Kamalbura/esp32-rc-race-car/calibration/logs/transmitter_aggressive_20260416_031819.csv

step_index | step_name | host_time_ms | device_ms | seq | A0 | A1 | A2 | A3 | enc_bits | enc_delta | sent | errors | ack
1 | center_rest | 24286 | 1888 | 1 | 18304 | 17711 | 18286 | 17692 | 3 | -1 | 1 | 0 | 0
1 | center_rest | 24286 | 1922 | 1 | 18306 | 17718 | 18291 | 17697 | 3 | -1 | 1 | 0 | 1
1 | center_rest | 24287 | 1937 | 1 | 18307 | 17715 | 18286 | 17692 | 3 | -1 | 1 | 0 | 1
1 | center_rest | 24287 | 1952 | 2 | 17900 | 17385 | 18284 | 17689 | 3 | -1 | 2 | 0 | 2
1 | center_rest | 24287 | 1966 | 2 | 18319 | 17717 | 18289 | 17692 | 3 | -1 | 2 | 0 | 2
1 | center_rest | 24288 | 1980 | 2 | 18307 | 17712 | 18282 | 17689 | 3 | -1 | 2 | 0 | 2
1 | center_rest | 24288 | 1995 | 3 | 18307 | 17705 | 18282 | 17684 | 3 | -1 | 3 | 0 | 2
1 | center_rest | 24289 | 2010 | 3 | 18304 | 17707 | 18284 | 17690 | 3 | -1 | 3 | 0 | 3
1 | center_rest | 24289 | 2024 | 3 | 18306 | 17717 | 18288 | 17692 | 3 | -1 | 3 | 0 | 3
1 | center_rest | 24289 | 2038 | 3 | 18307 | 17714 | 18286 | 17687 | 3 | -1 | 3 | 0 | 3
1 | center_rest | 24290 | 2072 | 4 | 18306 | 17708 | 18283 | 17698 | 3 | -1 | 4 | 0 | 3
1 | center_rest | 24290 | 2087 | 4 | 18302 | 17712 | 18282 | 17689 | 3 | -1 | 4 | 0 | 4
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
