Kamalbura/esp32-rc-race-car/receiver_code/secrets.example.h

#pragma once

// ESP-NOW pairing configuration.
//
// This file is gitignored. Copy secrets.h.example to secrets.h and fill in the
// peer MAC address and the 16-byte PMK/LMK shared by your transmitter and
// receiver. Both ends must use identical keys.
//
// Find a board's MAC with WiFi.macAddress() after WiFi.mode(WIFI_STA).

uint8_t TRANSMITTER_MAC[6] = {0xFF, 0xFF, 0xFF, 0xFF, 0xFF, 0xFF};

const uint8_t ESPNOW_PMK[16] = {
  0x00, 0x00, 0x00, 0x00, 0x00, 0x00, 0x00, 0x00,
  0x00, 0x00, 0x00, 0x00, 0x00, 0x00, 0x00, 0x00
};

const uint8_t ESPNOW_LMK[16] = {
  0x00, 0x00, 0x00, 0x00, 0x00, 0x00, 0x00, 0x00,
  0x00, 0x00, 0x00, 0x00, 0x00, 0x00, 0x00, 0x00
};
