Kamalbura/esp32-rc-race-car/(commit log)

2026-08-13 v7: speed-dependent steering authority, and move pairing keys out of source
    Steering:
    - steering gain scales with throttle (1.10 low speed -> 0.45 high speed) so
    low-speed turns stay tight while high-speed handling stays stable
    - time-based slew limiting with asymmetric rates: engage 1.80/s (reduced further
    by throttle), release 3.50/s, so turn-in is smoothed but straightening is quick
    - straight-assist deadband window and a stall guard floor at PWM 55
    Secrets:
    - ESP-NOW PMK, LMK and peer MAC moved from all 7 sketches into a per-folder
    secrets.h, gitignored, with secrets.h.example committed
    - Arduino compiles per sketch folder, so each gets its own copy
    - peer MACs also removed from c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
    [espnow_receiver_test.ino, espnow_transmitter_test.ino, receiver_code.ino, receiver_code_advanced_mpu.ino, transmitter_aggressive_logger_test.ino, transmitter_code.ino, transmitter_guided_calibration_test.ino]
2026-08-13 Merge Cyber Truck as V1 and add full documentation
    The Cyber Truck and this project are the same physical build: V1 used a
    commercial RC receiver, V2 kept the chassis and replaced the motors, battery
    and the entire radio link. Keeping them as separate repositories presented one
    project as two.
    - import V1 firmware under v1-cyber-truck/ (5 sketches; the identical
    cyber_truck_copy was dropped)
    - import build photos and test-ride/demo video into media/
    - README rewritten around the two generations, with the hardware evolution
    New documentation:
    - docs/HARDWARE.md both BOMs, pinouts, and why 1000rpm Johnson motors were
    replaced with 500rpm 555 geared motors (torque per t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
    [cyber-truck.ino, cyber_truck_dabble.ino, cyber_truck_serial_debug.ino, esp32_rc_car.ino, phase-2.ino]
2026-08-13 Rewrite README with a proper hero image and tighter structure
    The previous README led with hardware.jpg, a 2160x3840 portrait night shot of
    loose wiring - GitHub renders it full width, so it pushed the entire page out of
    view. test-ride-thumb.jpg (1280x720 landscape, daylight, finished body) was
    sitting unused and is the far better hero.
    - lead with the test-ride photo, width-constrained via <img>
    - hardware.jpg demoted to an 'Inside the chassis' section, floated right at
    360px so it illustrates rather than dominates
    - pull the motor torque decision up into its own section - it is the strongest
    engineering story in the project
    - badges now state real characteristics (100Hz, 120ms failsa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
2026-08-13 Rewrite README in the original Cyber Truck format, updated for V2
    The V1 repo's README structure was the one worth keeping - emoji section
    headers, hardware component tables, ASCII architecture diagrams, wiring
    breakdown, technical achievements. This restores that format and updates every
    section for the V2 hardware instead of replacing it with a different layout.
    - title reframed as Cyber Truck V2 so the lineage is explicit
    - new 'What Changed From V1' table plus the motor torque reasoning
    - hardware tables split into transmitter and receiver
    - wiring diagram rewritten for both ESP32-S3 boards
    - architecture diagrams redrawn for the two-board ESP-NOW topology and the
    packet processing pa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
2026-08-13 Port hardening, architecture docs and CI from the Vector-RC line
    That work existed in a local repo with no remote and was ahead of what was
    published here:
    - transmitter send-callback watchdog (SEND_CALLBACK_TIMEOUT_MS): recovers if
    onDataSent is lost under RF stress instead of latching the send loop off
    - ADC reads gated to the 100Hz send cadence rather than every loop iteration,
    cutting I2C work roughly 4x, while buttons/encoder stay polled every pass
    - ARCHITECTURE.md: layer-by-layer breakdown of networking, encryption,
    communication, configuration, control, concurrency and safety
    - CONTRIBUTING.md, .gitattributes, and a GitHub Actions workflow that compiles
    every sketch against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
